upenn-embedded/final-project-s26-t16-1/README.md

Review Assignment Due Date (https://classroom.github.com/a/-Acvnhrq)

# Final Project

**Team Number:** T16

**Team Name:** Sewing Machine

| Team Member Name | Email Address |
| --- | --- |
| Chris Chen | chrisc05@seas.upenn.edu |
| Ivy Jiang | ivyjiang@seas.upenn.edu |
| Evelyn Li | eli22@seas.upenn.edu |
| Daniel Lin | dl1n@seas.upenn.edu |

**GitHub Repository URL:** https://github.com/upenn-embedded/final-project-s26-t16-1

**GitHub Pages Website URL:** https://upenn-embedded.github.io/final-project-s26-t16-1/

## Final Project Proposal

### 1. Abstract

Our final project is a smart sewing machine with a wireless foot pedal and built-in thread usage tracking. The wireless pedal will use a pressure sensor to detect how hard the user is pressing and send that input wirelessly to the sewing machine, which will adjust motor speed in real time. A second part of the system will track spool or shaft rotation to estimate how much thread remains and display that information to the user on an LCD screen or other indicator. Overall, the project combines wireless communication, sensor input, motor control, and user feedback into one integrated embedded system.

### 2. Motivation

Conventional sewing machines usually use wired pedals and provide limited real-time information about machine operation. This creates usability limitations, including restricted pedal placement and difficult portability. Furthermore, there is no clear indication of the remaining thread or machine state. This is especially annoying when sewing complex pieces; users have to guess and check when to replace bobbin and spool thread and precision is limited by eyeballing. Our project addresses this by adding a wireless pressure-sensitive pedal and a sensing system that estimates thread usage during operation.
This project is interesting because it requires real-time interaction between mechanical and embedded subsystems. The device must sense pedal pressure, filter and transmit the input, adjust motor speed, count machine rotations, and provide output through a display or indicators. The intended purpose is to build a more flexible and informative sewing machine system that improves user control while demonstrating strong embedded system integration. It is also just cool because some members in our group love to sew and the chain locking mechanism is a marvel in itself, so it could be a cool mechanism to figure out.

### 3. System Block Diagram

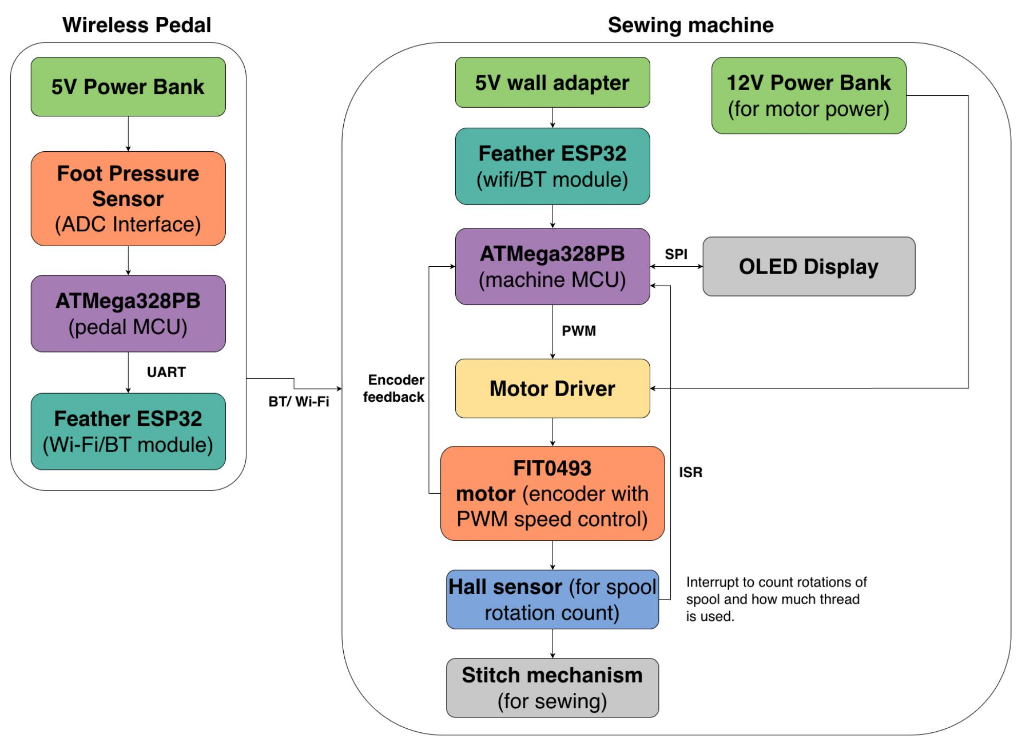
[picture p1: block_diagram.png]
 

### 4. Design Sketches

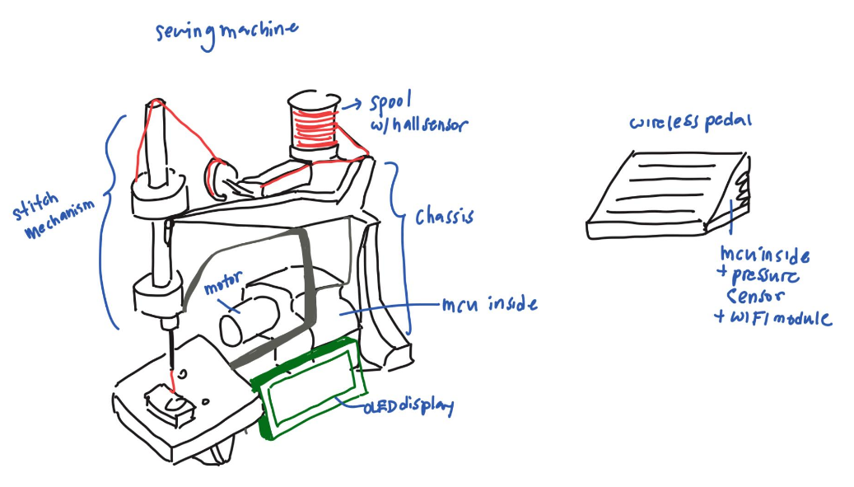
[picture p2: design_sketches.png]
 

We will need to 3D print the sewing machine components. Further, for the body and internal support of the machine, we will need power tools to cut it out of wood or acrylic.

### 5. Software Requirements Specification (SRS)

**Pedal Pressure to Speed Mapping**
The pedal MCU reads pressure and maps it to motor speed (higher pressure → higher speed).
Validation: Apply ≥5 pressure levels and verify speed increases monotonically.

**Wireless Command Transmission**
The pedal MCU sends speed commands wirelessly to the sewing machine MCU.
Validation: Perform ≥20 trials with ≥95% successful reception and response.

**Real-Time Motor Control**
The machine MCU adjusts motor speed based on pedal input.
Validation: Test ≥5 inputs and verify speed settles within 2 s.

**Rotation Counting**
The MCU tracks rotations using an encoder, Hall, or optical sensor.
Validation: Compare measured vs. actual rotations with ≤5% error.

**Thread Estimation**
Remaining thread is estimated from rotation count and spool geometry.
Validation: Compare estimate vs. expected value with ≤10% error.

**User Feedback**
System provides status via LED/OLED (power, thread, state).
Validation: Verify LED power indication and display updates during operation.

**Chain Stitch Mechanism**
The mechanism produces a continuous chain stitch.
Validation: Test on fabric and verify stitch remains continuous.

**Power Transmission**
Motor drives stitching mechanism without slip or stall.
Validation: Test across speed range and verify consistent motion.

**Frame Stability**
Structure remains stable during operation.
Validation: Run for several minutes and check for vibration or loosening.

**Pedal Usability**
Pedal supports repeated presses and returns to neutral.
Validation: Perform ≥50 cycles and verify consistent return and integrity.

**Spool Support**
Spool rotates smoothly and remains mounted.
Validation: Run repeated tests and verify no jamming or detachment.                                                                     |

### 6. Hardware Requirements Specification (HRS)

**Wireless Foot Pedal Hardware**
The system includes a portable foot pedal with an embedded pressure sensor and microcontroller to detect user input and transmit speed commands wirelessly.
Validation: Apply repeated low, medium, and high pressure inputs and verify that the pedal produces distinct sensor readings and successfully transmits commands.

**Dual-MCU Architecture**
The system uses two separate microcontrollers: one in the wireless pedal for pressure sensing and transmission, and one on the sewing machine for motor control, display output, and spool/thread monitoring.
Validation: Test each MCU separately, then validate the full system by confirming that pedal input is received and acted on by the machine-side MCU.

**Motor Drive Hardware**
The sewing machine includes a motor and motor driver capable of rotating the stitching mechanism at variable speeds based on pedal input.
Validation: Operate the motor at multiple commanded speeds and verify continuous rotation and response to speed changes without stalling under normal operation.

**Rotation Sensing Hardware**
The machine includes a sensor, such as an encoder, Hall-effect sensor, or optical sensor, to detect spool or shaft rotation for thread-usage estimation.
Validation: Rotate the shaft or spool through a known number of turns and verify that the sensor output matches the actual number of rotations.

**User Feedback Hardware**
The system includes at least one output device to indicate machine status, such as an OLED display or LED indicators.
Validation: Power on the system and confirm that the display or indicators activate correctly and update during operation.

**Power System**
The device includes a power source and regulation hardware capable of safely powering both microcontrollers, the wireless pedal, sensors, display, and motor-driving circuitry.
Validation: Run the full system under normal operation and verify that all components remain powered and functional without unintended resets or brownouts.

**Pressure Sensor Resolution**
The foot pedal pressure sensor provides enough range to distinguish at least three input levels: low, medium, and high pressure.
Validation: Record sensor outputs at different applied pressures and confirm that the three levels are clearly distinguishable.

### 7. Bill of Materials (BOM)

[BOM](https://docs.google.com/spreadsheets/u/1/d/1LjAFRgd7g9gQXnkkUFB2_QBa0-whRiNNrxztL-SXp3Q/edit?usp=sharing)

First, the source of our compute/signal processing for this project is the ATmega328PB XPlained mini board. This is ideal because it provides sufficient compute for processing of simple sensor data, is cheap and highly flexible when tuned with baremetal code. To facilitate wireless communication between two of these boards, a Feather ESP32 Wi-Fi module will be connected to each MCU. This is preferred because the Feathers provide bluetooth capabilities that are ideal for short distance, light-weight communication. They also provide access to wifi which gives us the flexibility of incorporating data storage, and IOT with this system without requiring significant changes in storage.
For our power source, we will utilize 3 sources in our testing phase. A 5V power bank will be utilized to power our foot pedal. A power bank is preferred because they have built in power regulation and are small and portable which is the entire purpose of having a detached foot pedal. 5V adapters plugged into the walls will be used to power the peripherals on the sewing machine side. For the motor, a separate 12V supporting 2A power adapter plugged into the wall will be used. We want to separate the power supply of the motor from the peripherals because the motor can cause significant current/voltage spikes.
Our pedal must be able to distinguish between multiple states which we do using a pressure sensor. We chose the FSR 402 because it has a sensing range of 0.3N to 150N which is the relative range that makes the pedal easy to control and not require too much force. The sensor is also durable supporting 10 million + actuations and has mm thickness.
For our motor, we choose the FIT0493 motor because it is relatively inexpensive, contains a built in encoder, supports PWM and should have more than enough torque at 12kg/cm. It takes 12V and draws a max current of 1.65A. Our motor driver supports this by being able to provide up to 3A. This is all supported by our 12V adapter.
We also require an LCU to display information to the user. In all honesty, the specs for this are unimportant for the operation of the device as long as SPI communication is supported.
We also use a hall-effect latch for spool rotation tracking rather than an optical sensor because sewing might produce significant debris and a magnetic sensor handles that well. Our chosen sensor takes in 5V and only requires 5mA to operate which matches well within the rest of the system.

### 8. Final Demo Goals

Will it be strapped to a person, mounted on a bicycle, or require outdoor space?

* It is a standalone machine with a portable foot pedal and connected to a battery, so no need to be strapped to anything or anyone.

Think of any physical, temporal, and other constraints that could affect your planning.

* Some constraints that can affect planning is that a sewing machine isn’t something that we can fit in a bag; it is quite big, so storage could be a constraint as well as methods to transport the parts back and forth.

### 9. Sprint Planning

How will you plan your sprint milestones?

* We will plan our sprint milestones as semi-long term goals. Focus on 1-2 big goals max and separate into 2 person groups to complete mini parts that work up to completing the overarching goal. For example if the unit time is 1 week, we will have the goal we want completed by the end of the week defined clearly. After defining this goal, define the sub goals that will be completed to complete the overall goal. Then, block out specific time blocks throughout the week to fulfill each goal. Finally, leave a few hours in case some tasks take longer than anticipated.

How will you distribute the work within your team?

* Everyone will be present when planning the sprints. We will just discuss which work we want to do and split accordingly. Nothing will be assigned without approval and we will discuss during in person sprint planning and over text for unanticipated tasks that come up.

**This is the end of the Project Proposal section. The remaining sections will be filled out based on the milestone schedule.**

## Sprint Review #1

### Last week's progress

This past week, we finalized BOMs (and ordered), worked on an intial physical CAD (and sent out to print) and wrote an inital version of the embedded code for the foot pedal system.

In terms of the BOM, the biggest change we made compared to the inital write up was we switchd the force sensor to a different model with a larger surface area for ease of integration and use. We also realized the power adapter we were planning on using does not source enough current to account for spikes in the motor so we made changes to this.

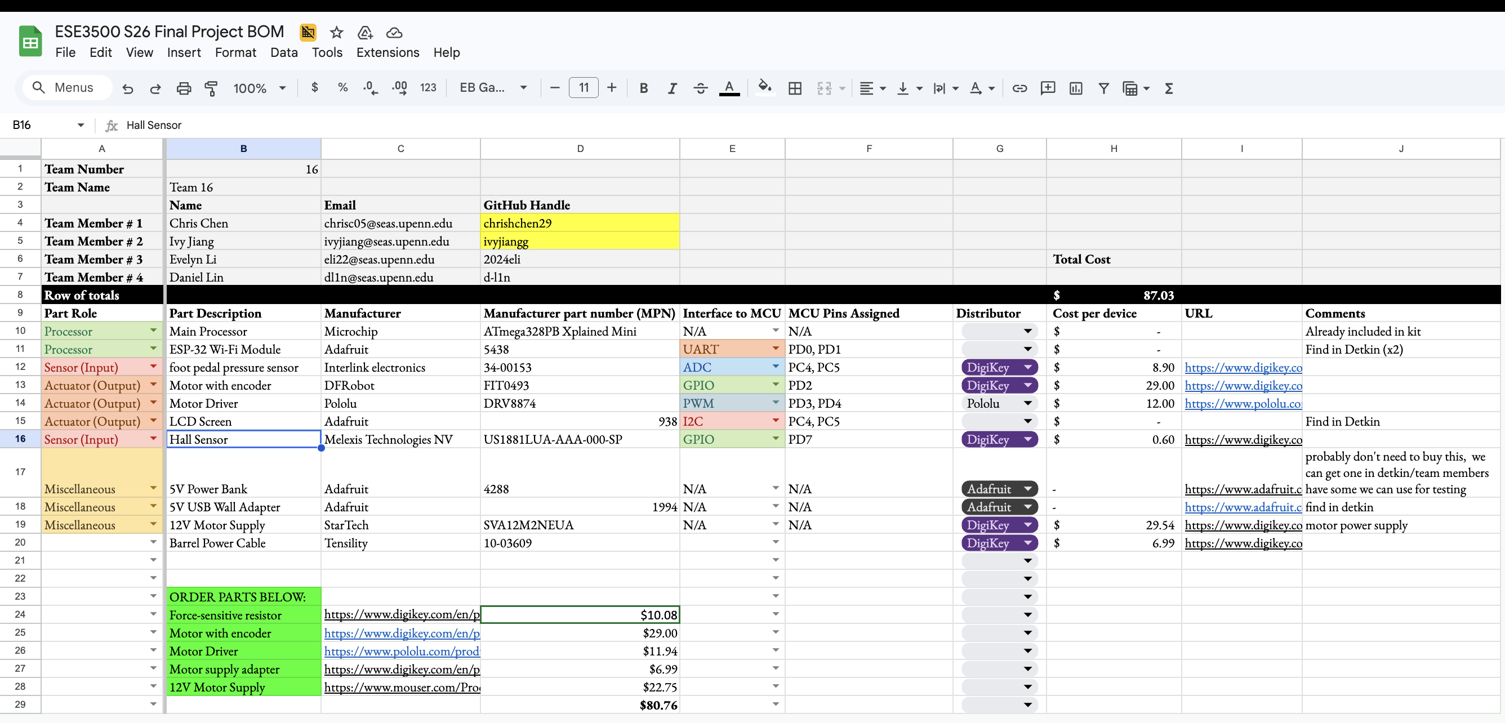
[picture p3: bom_wk1.png]


In terms code for the foot pedal, we have written and tested the functionality for measuring and reading the force from the sensor. This is the core of the control system.

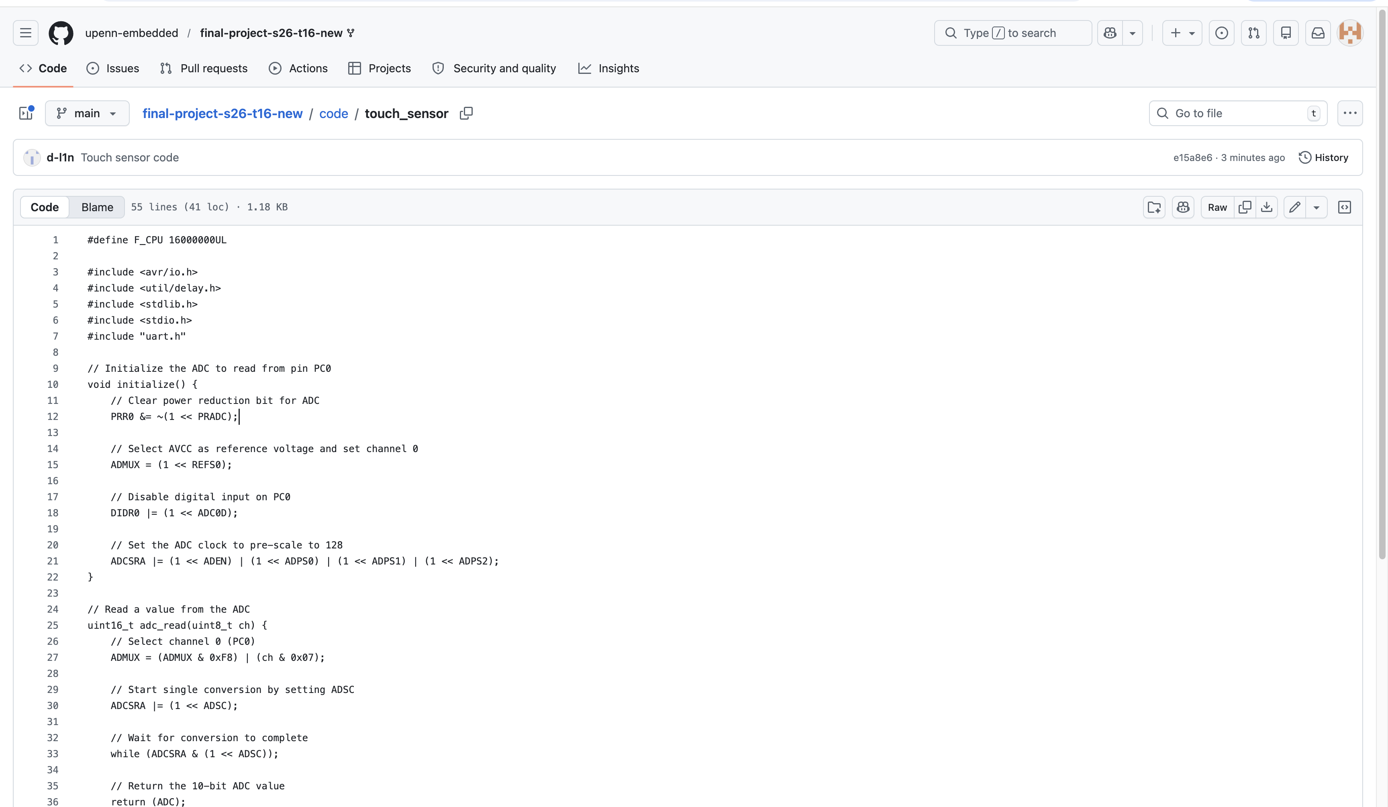
[picture p4: code-wk1.png]


For the physical CAD, we started from example CAD models on the internet and made the necessary adjustments to incorporate our components and detach the foot pedal from the rest of the machine to make our design more convenient and portable. Some of our components that we sent for printing are shone below.

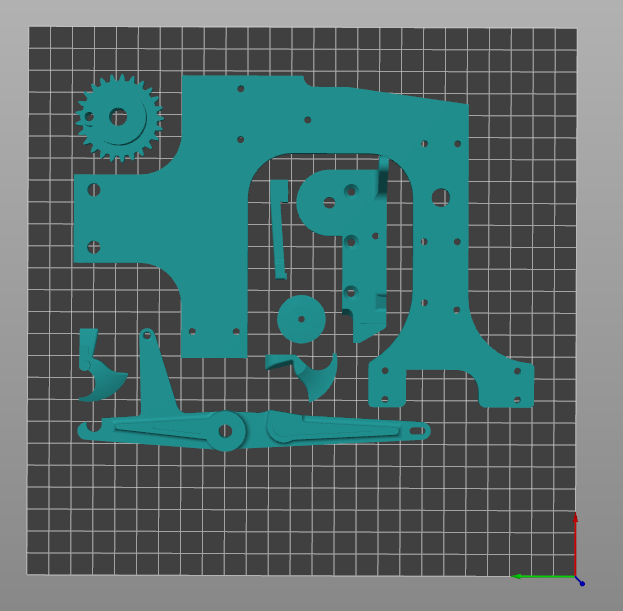
[picture p5: cad_photo_wk1.png]


Finally, we met as a team and aligned on direction and plans/goals for next week.

### Current state of project

Currently, the project is off to a good start. We have a very basic preliminary MVP of our "foot-pedal" system (both circuit and code) which is a core part of the project that will ultimately allow the user to control the sewing machine. We also have a first version for the gears and enclosure of the sewing machine.

Right now, the biggest bottleneck is just waiting for components to come in. That is, we have ordered electronic parts and are awaiting those to ship. We have also sent out 3D print jobs to RPL and are waiting for the first print to come back so we can iterate. The reason we want to the physical enclosure to come right now 1. printing takes a long time and 2. we want to make sure the elecontric components fit within the mechanical CAD and the gear works as expected.

In the meantime we are able to progress with components that are in Detkin. Some of these are parts we will use in our final version (feather, LCD screen, Hall sensor etc.) and some are alternate versions we are just using for test (force sensor, small motor)

### Next week's plan

Estimated time: 2 hours
Assigned: Daniel, Chris

Finalize foot-pedal subsystem - stress test code, integrate feather for wifi communication, integrate LCD screen displaying status. Being done means have a working system that consistently measures accurate pressue, is able to send it wirelessly and display it visually. Provided 3D print finishes in time, we also want to have this integrated. This group will also be responsible for following up with the 3D print and ensuring all components are printed/accounted for.

Estimated time: 2 hours
Assigned: Evelyn, Ivy

Begin the code and electronics to measure the amount of yarn left/used. This will mean building and testing the hall sensor electroncs and writing the code to support this. We also want to integrate feather for wifi communication on the ATMega connected to this system. Being done means having a hall sensor that can accurate measure rotations and communicte that via wifi.

*Note: not too much work assigned for this sprint due to midterms and team plans to meet for long work session the Sunday immediately after Sprint 2 is due.

## Sprint Review #2

### Last week's progress

This past week, we wrote code to verify the functionality of the hall-effect sensor set up the circuitry. The hall effect is up and functional.

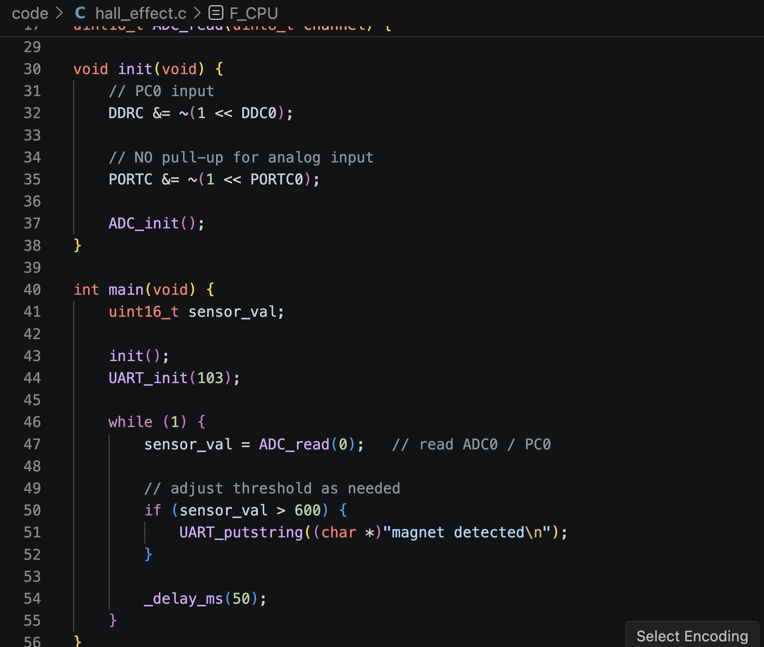
[picture p6: sprint2-hall.png]


We also partially assembled our mechanical sewing machine.


We re-CAD'd/ordered additional parts based on first iteration assemblies. We realized we need metal rods to support the physicaly sewing machine and act as axels for spinning parts. The power supply we ordered was also missing part of the adpater so we reordered this too.

We also cadded the enclosure for the foot pedal sensor and MCU.
text

Our motor driver came so we created a basic test circuit and verified that it works by driving a PWM signal using the detkin power supplies.
text

### Current state of project

I think currently we are on good pace. The hall effect sensor, motor, force sensor all have rough, working versions set up. The next step will be to polish up code a bit more and connect all these sections together via the ESP-32. We wanted to get this done last week, but we realized this is lower priority because other tasks require more iteration and may require ordering of additional parts + 3D printing new components which has a longer lead time.

The biggest current roadblocks are 1. we are waiting for metal rods to come in so that we can finish the mechanial assembly of our sewing machine. We are also waiting for the new power adpater head to come in so that we can test the operation of our project without relying on the power supply.

In the meantime, we will keep testing and integrating using the detkin power supply. We have also 3D printed rods that we can use for now while we wait for the metal rods to come in.

### Next week's plan

Assigned: Evelyn, Ivy, Daniel, Chris
Estimated time: 8 hours

We will fully assemble the sewing machine and test to see if the motor can move the machine. We will also attach the hall sensor and magnet to the spool in order to measure rotations. We will also connect the LCD screen so that it displays rotations.

Overall, we want to polish the different electrical subsystems and integrate them together and support wireless communication. We hope to be ready for the MVP!

## MVP Demo

### 1. Show a system block diagram & explain the hardware implementation.

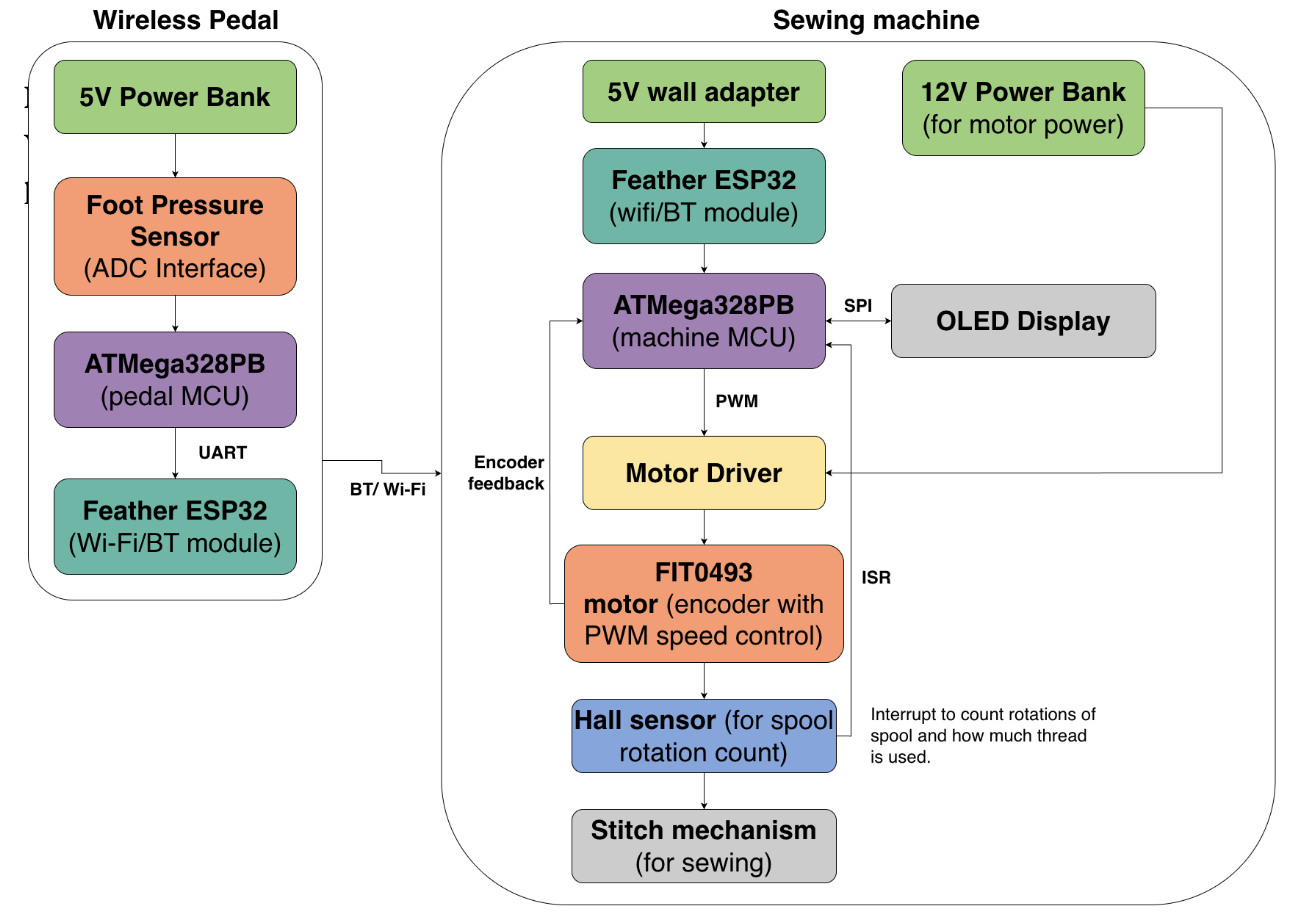
[picture p8: mvpblock.png]
mvpblock


In our current version of the MVP, we have an ATMega328PB (the peripheral controller) that takes in as ADC input the value from a force pressure sensor. This is transmitted via UART to an ESP32 Feather, which transmits the ADC value wirelessly to a second ESP32. The second ESP32 transmits this ADC value via UART to a second ATmega328PB (the central controller), which interprets the value and changes the duty cycle of the PWM signal that enables the DC motor accordingly. We power the peripheral ATmega328PB and the ESP32 using 6 AA batteries in series (9V nominal), with an LDO down to 5V.

### 2. Explain your firmware implementation, including application logic and critical drivers you’ve written.

For firmware, we implemented the embedded control stack across two microcontrollers that coordinate the sewing machine. On the pedal-side controller, Daniel wrote ADC sensing logic to continuously sample the pressure sensor, filter readings, and convert force input into a speed command. We then built the wireless communication layer using ESP-NOW/Wi-Fi to transmit pedal data with low latency and confirm successful packet delivery.

On the sewing-machine controller, we developed/used existing UART drivers and wrote parsing logic to receive commands from the wireless bridge, then used that data for real-time motor control so pedal pressure directly maps to motor speed. Also wrote application logic for telemetry peripherals, including Hall-effect sensor (showing that we can sense change but haven't fully done rotation counting yet) for thread usage estimation and display update routines for user feedback, but these haven't been fully integrated as they were secondary priorities.

### 3. Demo your device.

Showing a TA + will record.

[20260417_113638_IMG_5753.MOV](assets/20260417_113638_IMG_5753.MOV)

### 4. Have you achieved some or all of your Software Requirements Specification (SRS)?

We achieved almost all of our SRS indepenently and still need to integrate them. The wireless transmission of the foot pedal force to the motor speed works well, and we validated the Hall effect sensor reading separate from this. We still have to setup the LCD screen to print the spool remaining and other parameters.

### 5. Have you achieved some or all of your Hardware Requirements Specification (HRS)?

We've fully built out our sewing machine and all parts are electrically integrated into separate parts of the system and controllers, but we haven't put any of the electronics onto the machine. The integration testing will consist of using the DC motor to actually spin the mechanical enclosure, which are sparate parts at the moment.

machine_assembly


mvpelectronics


### 6. Show off the remaining elements that will make your project whole: mechanical casework, supporting graphical user interface (GUI), web portal, etc.

We need to put the electronics on the sewing machine and figure out how to wire everything efficiently. As for main peripherals left, we mostly just telemetry which means setting up an LCD display (similar to Lab 4 Pong) and feeding spool count data into it.

### 7. What is the riskiest part remaining of your project?

Stress testing and making sure we don't break the machine as well as making sure all parts stay in tact when rewiring and integrating into the machine. We used 3D-printed rods instead of metal rods for the rotating pieces of the mechanical assembly, which can be risky as 3D-printed parts are much more brittle and prone to tolerance issues. This means we would likely not be able to sew any thick fabrics.

### 8. What questions or help do you need from the teaching team?

None as of now. Just maybe how to improve?

### Current state of project

We are in good shape for the final demo. Almost everything works functionally except for the display and hall effect sensor for telemetry which is a stretch goal that we can work on in the following week.

### Next week's plan

We will integrate the display and hall effect sensor for telemetry into the sewing machine and integrate it into existing code. Since we've finished a rough MVP for this week, we can now work on polishing the circuit boards -- soldering rather than using breadboards and putting it on the machine -- as well as making our code readable and modularized. Also we would like to stress test our machine to make sure it won't break on Demo Day.

## Final Report

Don't forget to make the GitHub pages public website!
https://upenn-embedded.github.io/final-project-s26-t16-1/

***NOTE!!! Our final website is made using our index.md file NOT this README
# Gertrude

ESE3500 Final Project: Embedded Sewing Machine for wireless control and smart resource usage prediction

</div>

<div class="section" markdown="1">

## Video

<div style="position: relative; padding-bottom: 56.25%; height: 0;">
  <iframe 
    src="https://www.youtube.com/embed/aF5EwkLu-dE" 
    frameborder="0" 
    allowfullscreen
    style="position: absolute; top: 0; left: 0; width: 100%; height: 100%;">
  </iframe>
</div>

[Open demo video](https://www.youtube.com/watch?v=aF5EwkLu-dE)

</div>

<div class="section" markdown="1">

## Images

<div class="image-grid">
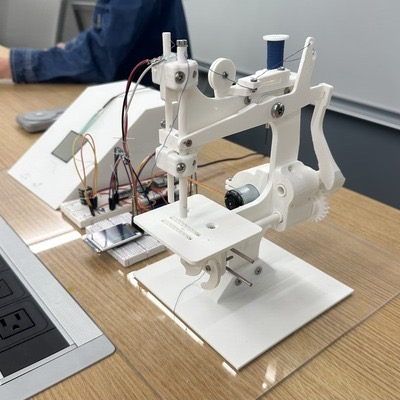
[picture p11: final images/400x400.JPG]
400x400 Thumbnail
  
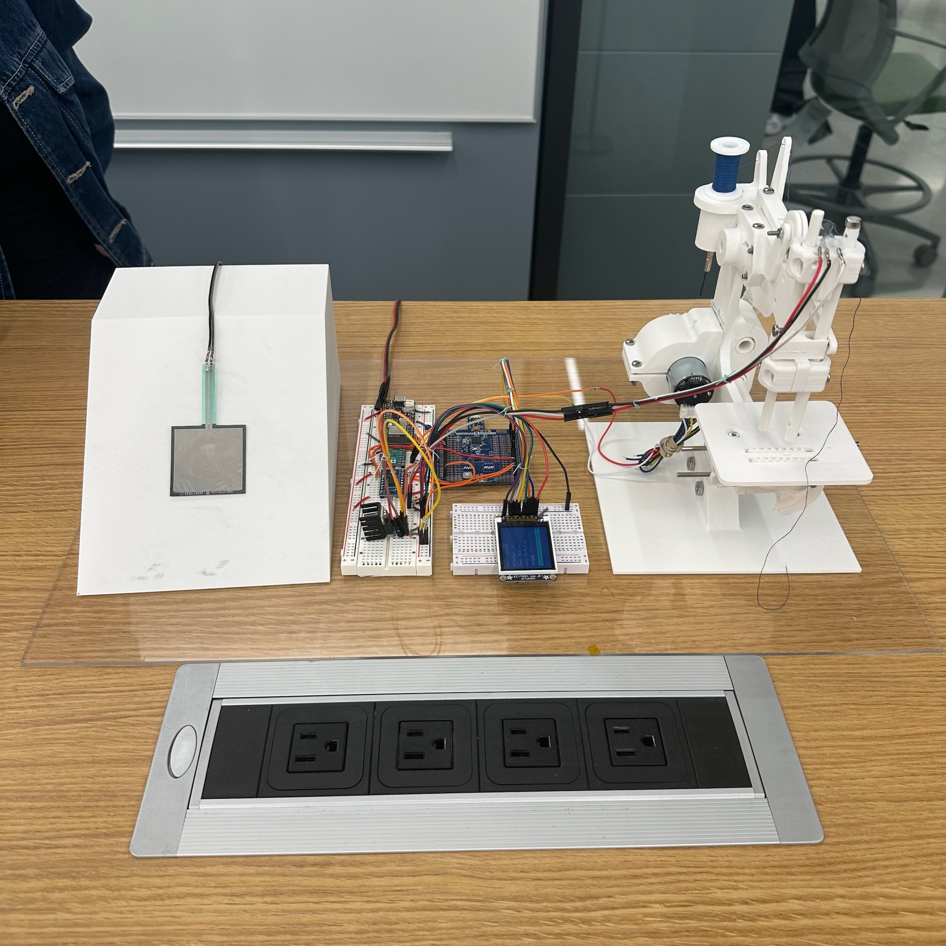
[picture p12: final images/IMG_1396.jpeg]
Final project image
  
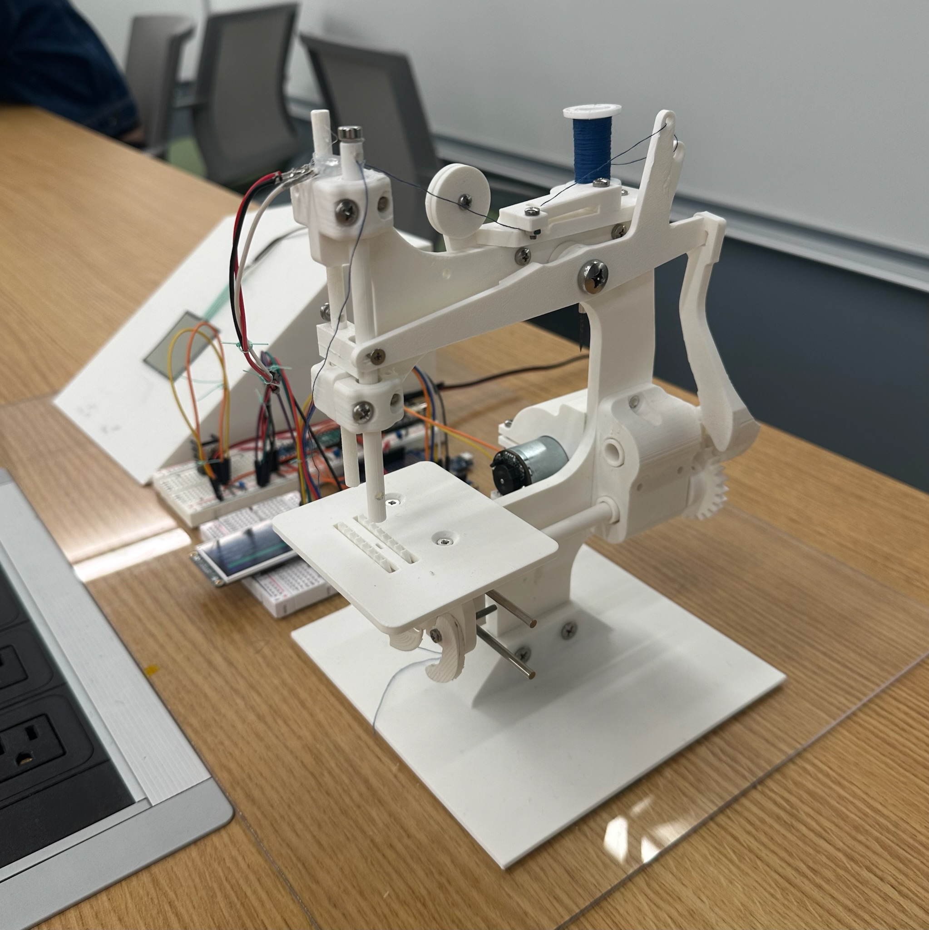
[picture p13: final images/IMG_1398.jpeg]
Final project image
  
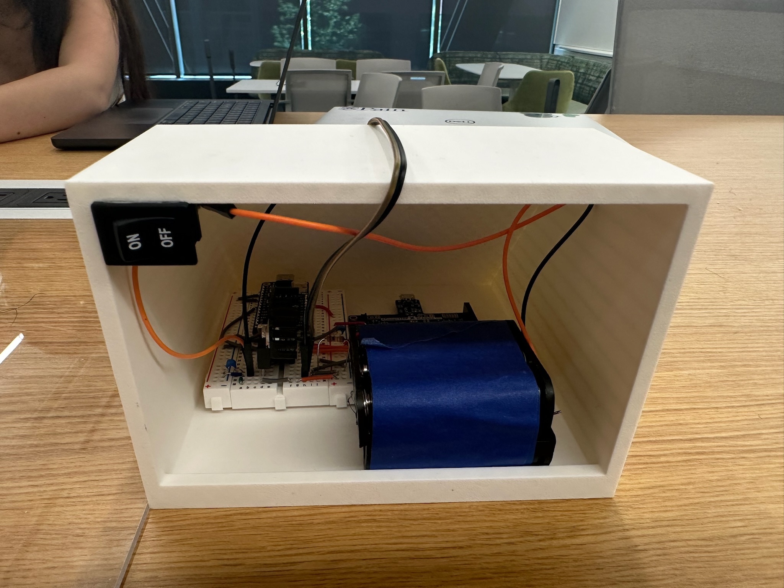
[picture p14: final images/IMG_1401.jpeg]
Final project image
  
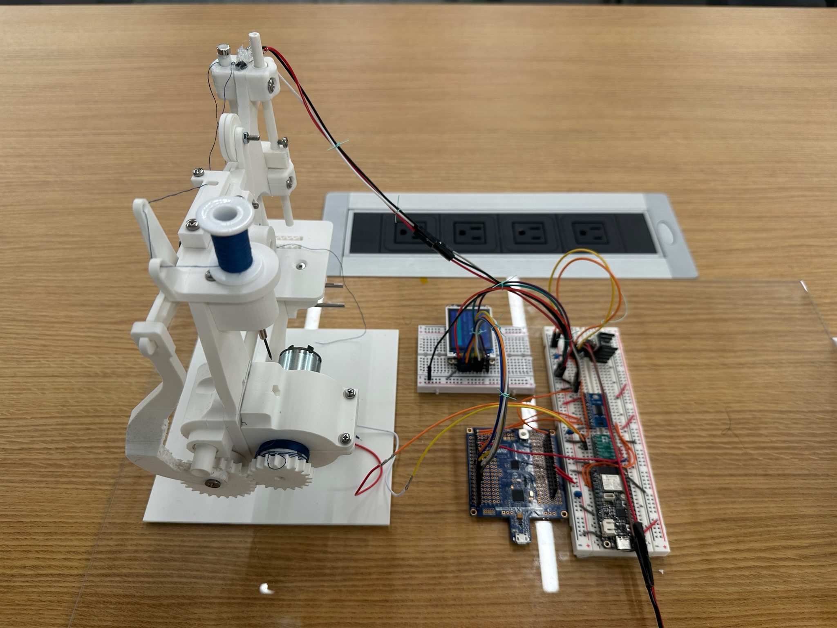
[picture p15: final images/IMG_1403.jpeg]
Final project image
  
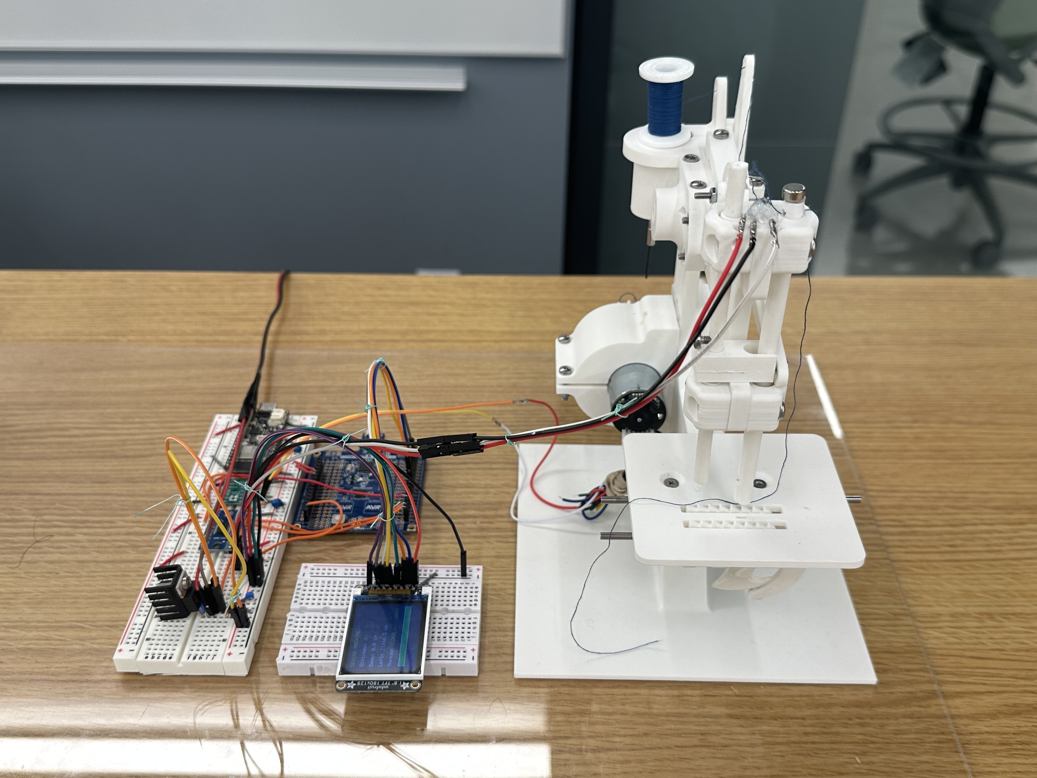
[picture p16: final images/IMG_1404.jpeg]
  
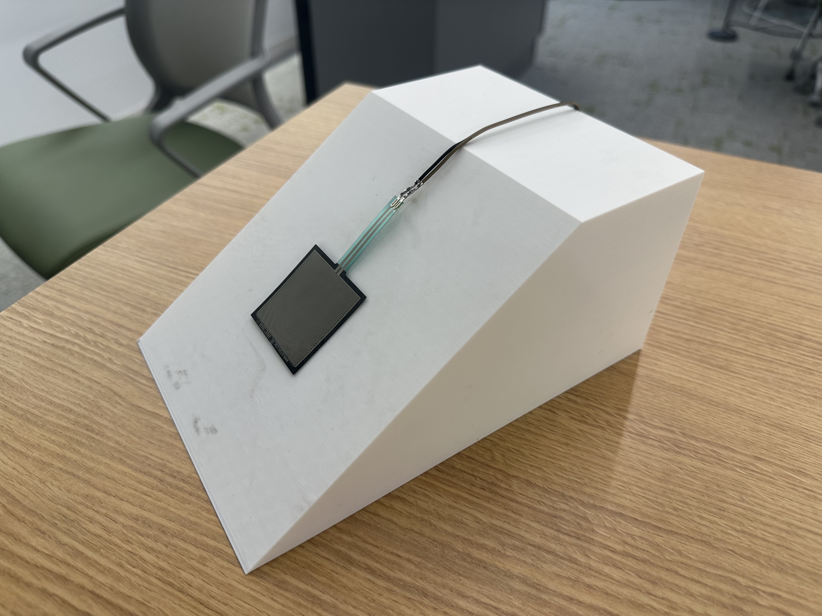
[picture p17: final images/IMG_1406.jpeg]
  
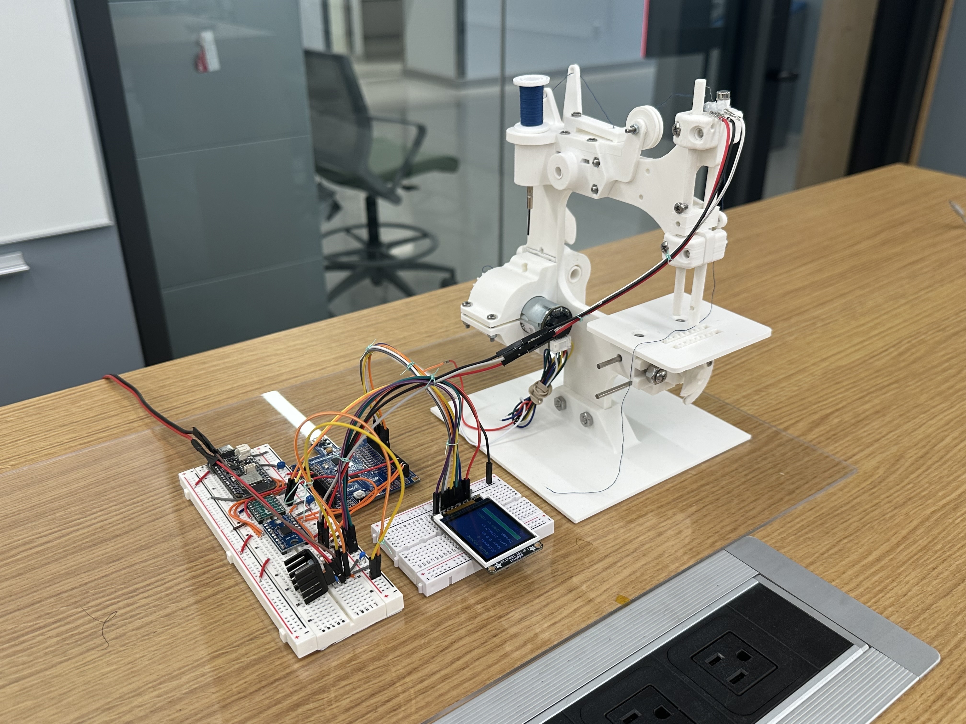
[picture p18: final images/IMG_1407.jpeg]
  
</div>

</div>

<div class="section" markdown="1">

## Progress Shots

<div class="image-grid">
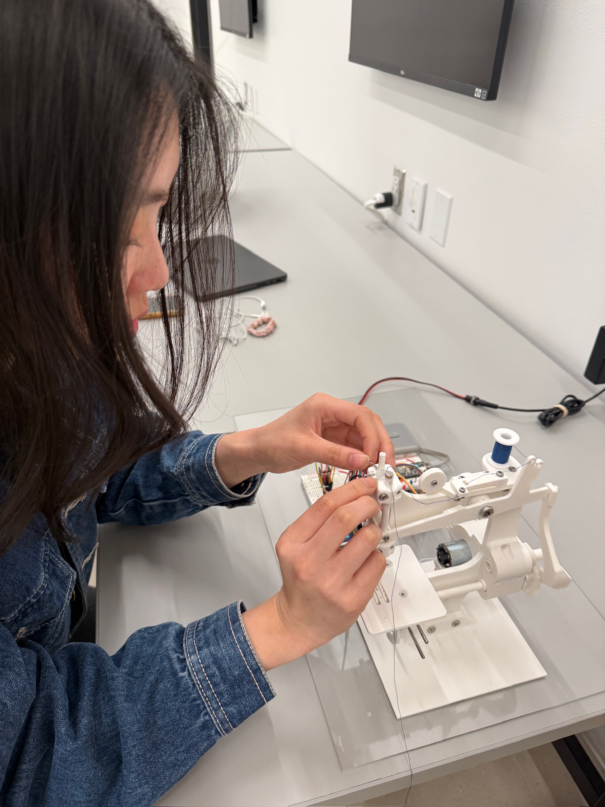
[picture p19: progress/IMG_4221.JPG]
Progress shot
  
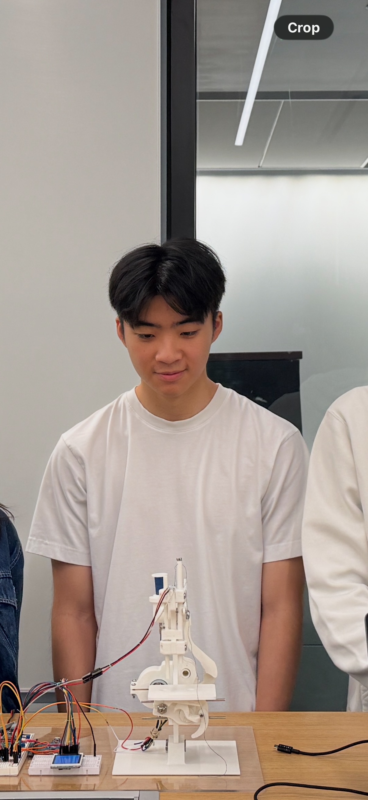
[picture p20: progress/IMG_4233.jpeg]
Progress shot
  
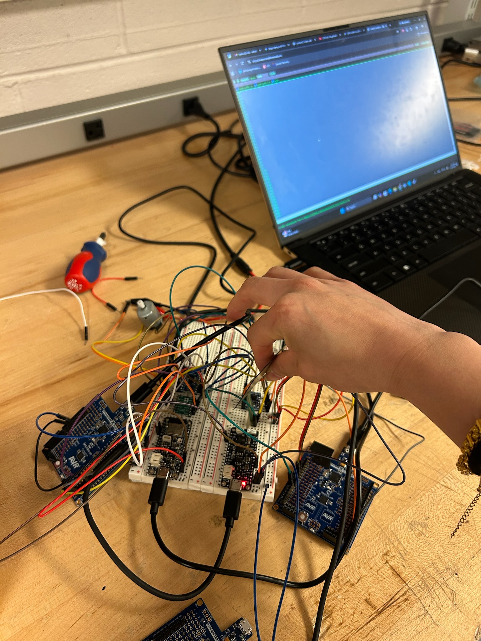
[picture p21: progress/IMG_5754.jpeg]
Progress shot
  
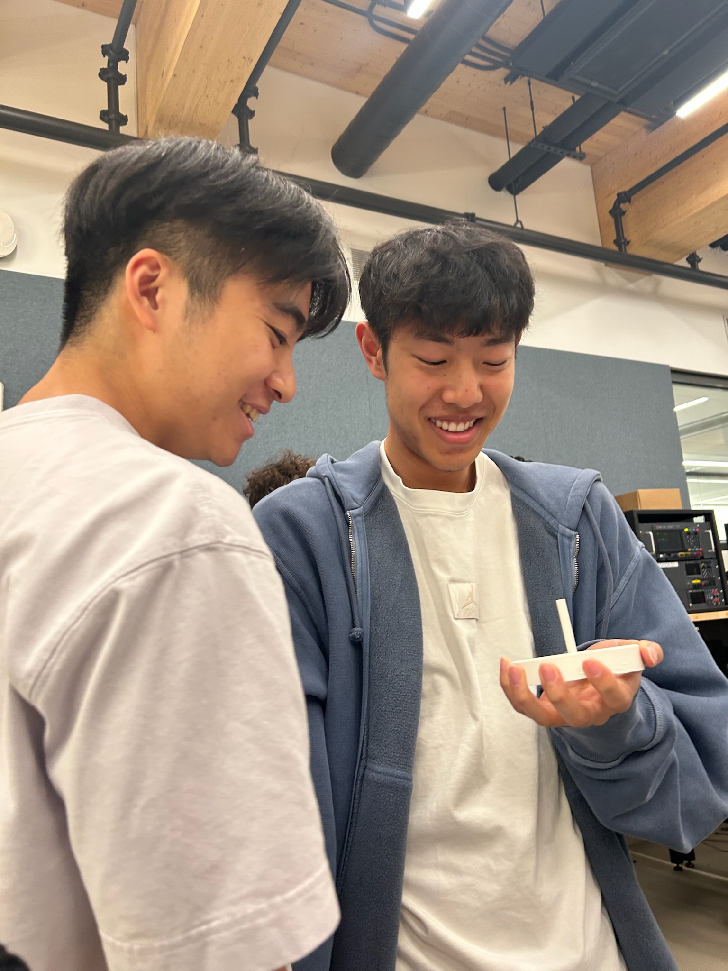
[picture p22: progress/IMG_6074.jpeg]
Progress shot
  
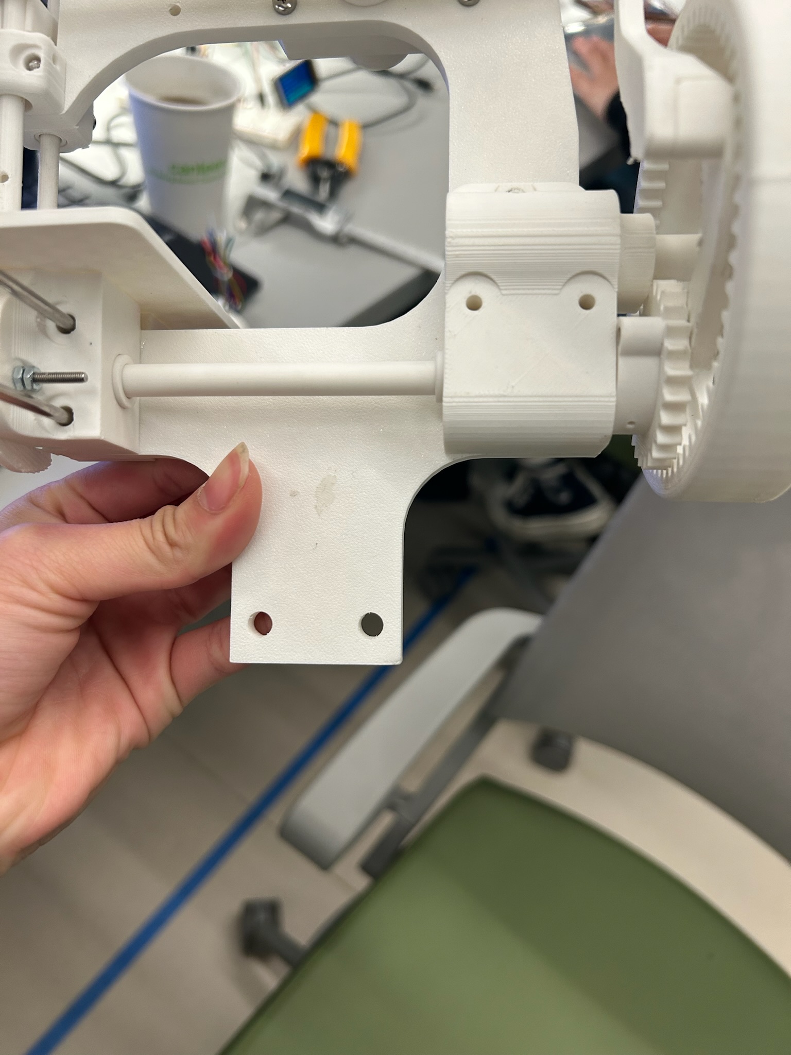
[picture p23: progress/IMG_5991.jpeg]
Progress shot
  
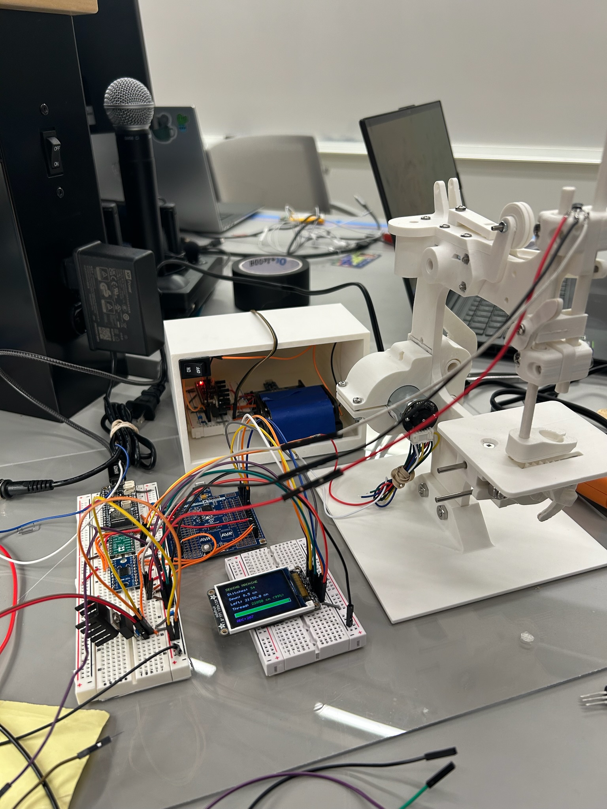
[picture p24: progress/IMG_6068.jpeg]
Progress shot
  
  MVP block diagram
  Progress shot
</div>

</div>

<div class="section" markdown="1">

## Results

In the end, our sewing machine "Gertrude" was very close to the product we envisioned
from the beginning. It contained a PLA 3-D printed sewing machine complete with fully
function gears, hooks and pedals powered by a DC motor. It possessed a detached
"foot-pedal" that utilized a force sensor to control the speed of the sewing machine and
use 2 ATMegas to handle embedded computations and 2 ESPs running ESP-Now to handle
wireless communication. Finally, a hall effect sensor was used to measure yarn usage
and display relevant information like "total stiches" on an onbard LCD screen.

</div>

<div class="section" markdown="1">

## Software Requirements Specification (SRS) Results

Based on our quantified system performance, we were able to meet most of our core software requirements, particularly those related to user interaction and system feedback. The LCD display requirement (SRS-06) was fully achieved, as the system consistently provided real-time updates of stitch count and system status. This demonstrated strong integration between sensing, processing, and user output, and validated that our software pipeline from sensor input to display was reliable.

However, we fell slightly short in fully meeting the rotation counting requirement (SRS-04). While the Hall-effect sensor successfully detected and tracked spool rotations, small inaccuracies were observed, especially at higher motor speeds. These errors were likely caused by missed sensor transitions or noise in the signal, indicating limitations in our polling or interrupt handling approach. Although the system functioned correctly at a conceptual level, the measured counts did not always remain within the desired accuracy range.

Overall, the system achieved its primary functional goals, with reliable real-time control and feedback. The remaining shortcomings are primarily related to signal robustness and measurement precision, which could be improved through better interrupt handling, signal conditioning, or filtering in future iterations.

| ID | Description | Validation Outcome |
| --- | --- | --- |
| **SRS-04** | The sewing machine microcontroller shall track spool or shaft rotations using a Hall-effect sensor. | Partially Confirmed, the Hall sensor and magnet successfully incremented rotation/stitch count displayed on the LCD, matching visible spool movement during operation. Minor inaccuracies occurred at higher speeds due to missed transitions or signal noise. Demonstrated in demo video and system output 
| **SRS-06** | The system shall provide user feedback through an LCD display to indicate system status and usage metrics such as stitch count. | Confirmed, the LCD powered on correctly and updated in real time to reflect stitch count and system state during operation. Consistent behavior is shown in demo video and images 

SRS-04 Proof:

<div style="display: flex; justify-content: center;">
  <iframe 
    width="315" 
    height="560"
    src="https://www.youtube.com/embed/GNKjsASPulc"
    frameborder="0"
    allowfullscreen>
  </iframe>
</div>

[Open SRS-04 proof video](https://www.youtube.com/watch?v=GNKjsASPulc)

SRS-06 Proof:

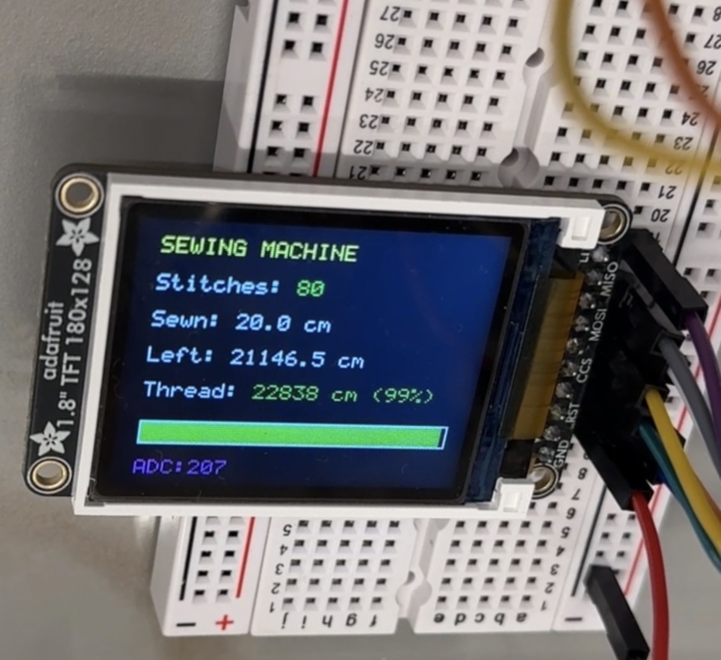
[picture p25: lcdscreensrs.jpg]
SRS-06 Proof


</div>

<div class="section" markdown="1">

## Hardware Requirements Specification (HRS) Results

We met almost all of the hardware requirement initially outline in our project proposal. A brief overview of these requirments and our ultimate design is discussed below:

### Wireless Foot Pedal Hardware

The system shall use two separate microcontrollers: one located in the wireless pedal for pressure sensing and transmission, and one located on the sewing machine for motor control, display output, and spool/thread monitoring.

Validation: Yes, this was met and the locations were as planned. This is demonstrated in the images above.

The sewing machine shall include a motor and motor-driving circuit capable of rotating the stitching mechanism at variable speeds based on pedal input.

Validation: Yes, this was met, and a functioning motor is outline in the demo video.

The machine shall include a hardware sensor, such as an encoder, Hall-effect sensor, or optical sensor, to detect spool or shaft rotation for thread-usage estimation.

Validation: We did include sensors to count spool usage/number of rotations in the form of a hall effect sensor and magnet. Agin, demonstrated in demo video.

The system shall include at least one hardware output device to indicate machine status, such as an OLED display and/or LED indicators.

Validation: The visual display came in the form of a status LED on the sewing machine side ATMega as well as the LCD screen turning on.

### Power System

The device shall include a power source and regulation hardware capable of safely powering both microcontrollers, the wireless pedal, sensors, display, and motor-driving circuitry.

Validation: This was achieved and functioning machine is proof of that. Specifcally, we utlized 6 AA batteries in series for a nominal battery voltage of 9V, 9V to 5V and 3.3V LDO, wall to 12V socket and fixed 5V portable power supply.

| ID | Description | Validation Outcome |
| --- | --- | --- |
| HRS-01 | The system shall include a portable foot pedal with an embedded pressure sensor and microcontroller to detect user input and transmit speed commands wirelessly. | Confirmed, could communicate wirelessly up to 50+ meters away. [Video1](validation/Video1.mov) shows example of wireless communication working. |
| HRS-07 | The foot pedal pressure sensor shall provide enough measurable range to distinguish between at least three user input levels: low, medium, and high pressure. | Confirmed, could see very visible differences in motor speed depending on force applied. End of demo video on website shows difference speeds, LCD screen shown in [Video1](validation/Video1.mov) also zooms in on ADC reading of pressure sensor. |

</div>

## Conclusion

In conclusion, we had a lot of fun but also learning moments working on Gertrude. We learned a lot about debugging and working step by step up from a minimum viable product to a fully embedded sewing machine. 
What went well was that we planned out our time very well and were able to rapidly prototype if a design wasn't working or if a part was missing. For instance, we initially had significant issues getting our UART bridge to work between the ATMega used to sense the ADC value on the pressure sensor to the ESP-32, transmitting over ESP-NOW to the second ESP-32, and getting the value from the secon ESP-32 to the second ATmega over UART for processing with the motor. We found this issue to be because we were trying to read from UART channel 2 on the second ESP-32 when in reality the ESP-32 we used only had two UART channels (channel 0 and channel 1). We spent significant time debugging this issue (on the order of several hours) and the fact that we planned our time very well meant that we were able to resolve issues like this without it pushing back our timeline too much. Another major issue we face was on the integration side. When we tried to integrate the code controlling our motor duty cycle with the code for the Hall effect sensor and the LCD screen, we found that neither the LCD screen nor the motor worked properly. We eventually found out that the cause of this issue was that both them motor driver and the LCD screen used timer 0 on different channels, so our integrated code only worked when we switched the LCD screen to timer 2.

We were also a super communicative team, so it was easy to know what to work on and how to get it done. Overall, pretty much everything worked except that the needle was misaligned causing our machine to be unable to stitch. To solve this problem, next time, we would probably align the hook better so that it could grab the needle thread at the right moment. In general, we could probably have spent more time iterating on the open-source CAD design we found to meet our design requirements, because some of the open-source CAD files did not match what we were looking for - for instance, the model we used was designed to be run with metal rods, but we only had access to 3D-printed rods which made the tolerance issues of our device worse. Overall, we're super proud of the team for pushing through challenges and making a functional sewing machine!

## References
ESP-Now 

UART Library (Labs 1-4)

LCD Library (Lab 4)
