upenn-embedded/final-project-s26-t16-1/index.md

<style>
  body {
    background: #fbf7ef;
    color: #263331;
  }

  .report {
    max-width: 980px;
    margin: 0 auto;
    padding-bottom: 36px;
  }

  .title-block {
    margin: 18px 0 28px;
    padding: 28px 0 18px;
    border-bottom: 3px solid #9fc9bd;
  }

  .title-block h1 {
    margin-bottom: 8px;
    color: #1f625f;
  }

  .title-block p {
    margin: 0;
    color: #536660;
    font-size: 1.1rem;
  }

  .section {
    margin: 26px 0;
    padding: 22px;
    background: #ffffff;
    border: 1px solid #d9ded3;
    border-radius: 6px;
  }

  .section h2 {
    margin-top: 0;
    color: #1f625f;
  }

  .section h3 {
    color: #33413e;
  }

  .image-grid {
    display: grid;
    grid-template-columns: repeat(auto-fit, minmax(190px, 1fr));
    gap: 12px;
  }

  .image-grid img {
    width: 100%;
    height: 190px;
    object-fit: cover;
    border: 1px solid #d9ded3;
    border-radius: 4px;
    background: #f2eee4;
  }

  table {
    display: table;
    width: 100%;
    border-collapse: collapse;
    background: #ffffff;
  }

  th {
    background: #e3eee4;
  }

  th,
  td {
    padding: 10px;
    border: 1px solid #d9ded3;
    vertical-align: top;
  }
</style>

<div class="report" markdown="1">

<div class="title-block" markdown="1">

# Gertrude

ESE3500 Final Project: Embedded Sewing Machine for wireless control and smart resource usage prediction

</div>

<div class="section" markdown="1">

## Video

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

[Open demo video](https://www.youtube.com/watch?v=aF5EwkLu-dE)

</div>

<div class="section" markdown="1">

## Images

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

</div>

<div class="section" markdown="1">

## Progress Shots

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

</div>

<div class="section" markdown="1">

## Results

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

</div>

<div class="section" markdown="1">

## Software Requirements Specification (SRS) Results

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

SRS-04 Proof:

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

[Open SRS-04 proof video](https://www.youtube.com/watch?v=GNKjsASPulc)

SRS-06 Proof:

SRS-06 Proof

</div>

<div class="section" markdown="1">

## Hardware Requirements Specification (HRS) Results

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

### Wireless Foot Pedal Hardware

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

Validation: Yes, this was met, and a functioning motor is outline in the demo video.

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

### Power System

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

Validation: This was achieved and functioning machine is proof of that. Specifcally, we utlized 6 AA battery back, 9V to 5V and 3.3V LDO, wall to 12V socket and fixed 5V portable power supply.

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

</div>

<div class="section" markdown="1">

## Conclusion

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

## References
ESP-Now 

UART Library (Labs 1-4)

LCD Library (Lab 4)

</div>
</div>
