upenn-embedded/final-project-s26-t16-1/final images/IMG_1402.jpeg

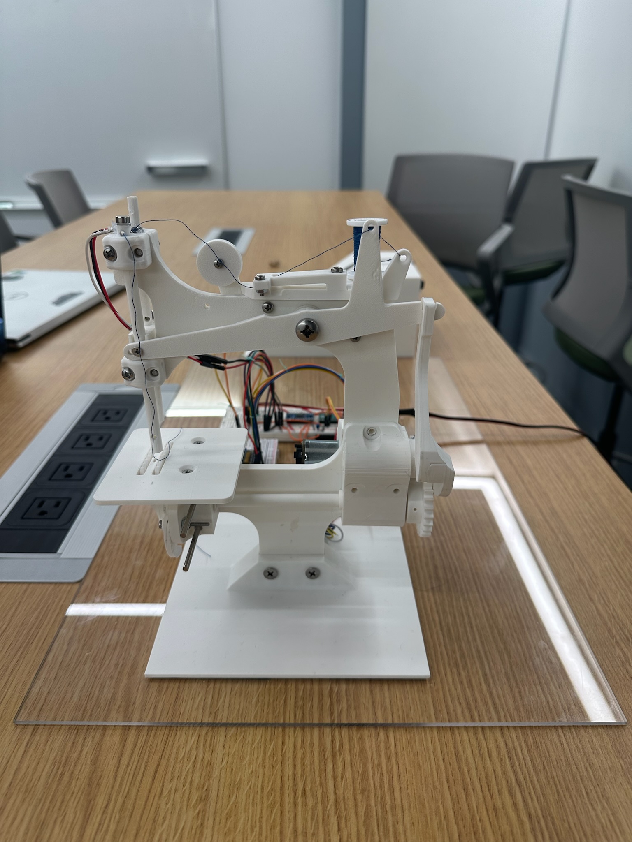
final images/IMG_1402.jpeg
