upenn-embedded/final-project-s26-t16-1/final images/thumbnail.JPG

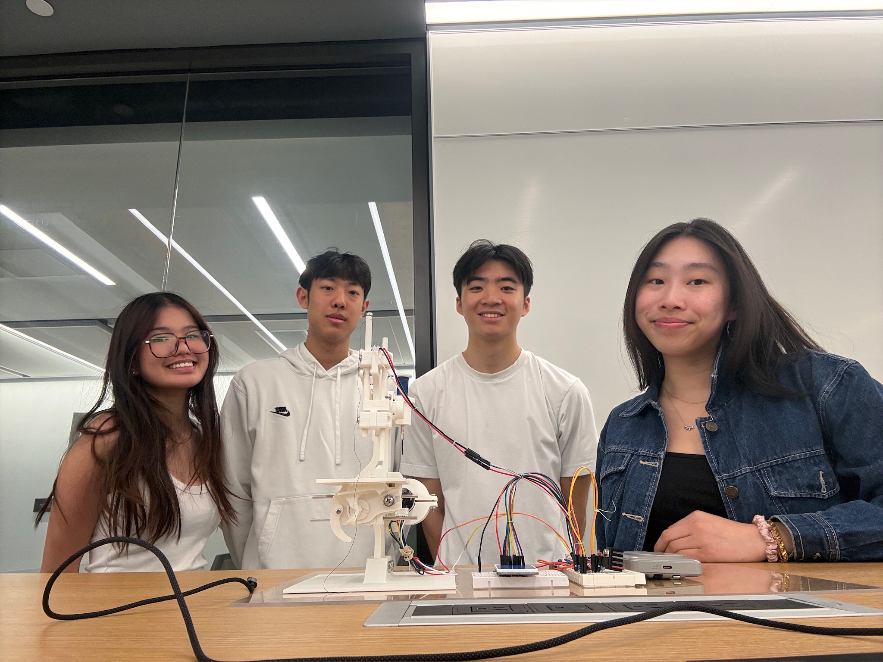
final images/thumbnail.JPG
