upenn-embedded/final-project-s26-t16-1/code/4-10/central_controller/central_controller.ino

#include <HardwareSerial.h>

HardwareSerial ATmegaSerial(2);
#define ATMEGA_RX_PIN 38 // ESP32 RX to ATmega TX (PD1)
#define ATMEGA_TX_PIN 33 // ESP32 TX to ATmega RX (PD0)

void setup() {
    Serial.begin(115200);
    ATmegaSerial.begin(9600, SERIAL_8N1, ATMEGA_RX_PIN, ATMEGA_TX_PIN);
    
    Serial.println("ESP32 Test Sender Ready.");
    Serial.println("Waiting 3 seconds before starting...");
    delay(3000);
}

void loop() {
    // Send an 'X' every 2 seconds
    static unsigned long lastTime = 0;
    if (millis() - lastTime > 2000) {
        lastTime = millis();
        Serial.println("ESP32: Sending 'X' to ATmega...");
        ATmegaSerial.print('X'); 
    }

    // Read information sent back from ATmega
    while (ATmegaSerial.available()) {
        Serial.write(ATmegaSerial.read());
    }
}
