upenn-embedded/final-project-s26-t16-1/code/4-10/touch_sensor.c

#define F_CPU 16000000UL

#include <avr/io.h>
#include <util/delay.h>
#include <stdlib.h>
#include <stdio.h>
#include "uart.h"

// Initialize the ADC to read from pin PC0
void initialize() {
   PRR0 &= ~(1 << PRADC);
   ADMUX = (1 << REFS0);
   DIDR0 |= (1 << ADC0D);
   ADCSRA |= (1 << ADEN) | (1 << ADPS0) | (1 << ADPS1) | (1 << ADPS2);   
}

// Read a value from the ADC
uint16_t adc_read(uint8_t ch) {
   ADMUX = (ADMUX & 0xF8) | (ch & 0x07);
   ADCSRA |= (1 << ADSC);
   while (ADCSRA & (1 << ADSC));
   return (ADC);
}

int main() {
   initialize();   
   uart_init(); 
   
   uint16_t adc_result;

   while (1) {
       // Read from ADC channel 0 (PC0)
       adc_result = adc_read(0);
       
       // Print the decimal value 
       printf("ADC Value on PC0: %u\n", adc_result);
       
       _delay_ms(250); 
   }
   return 0;
}
