upenn-embedded/final-project-s26-t16-1/(commit log)

2026-04-03 Touch sensor code
2026-04-17 Revert "debugging attempt 1"
    This reverts commit ef33023dab00a9f186a0e5503c1c9ae4ce93ad36.
    [peripheral_controller.c, uart.c]
2026-04-17 Integrate ESP-NOW for ADC data communication
    Added ESP-NOW functionality for ADC value transmission.
2026-04-17 Refactor central_controller.c for ESP32 and ATmega integration
2026-04-17 Refactor central_controller for AVR with UART and PWM
    Refactored code to implement UART and PWM functionalities, removing ESP32 specific code.
2026-04-20 hall effect
2026-04-20 hall effect thread predict logic
2026-04-22 hall effect callibrate
2026-04-24 Updated timer to use Timer 2
