upenn-embedded/final-project-s26-t16-1/sprint2-1.jpeg

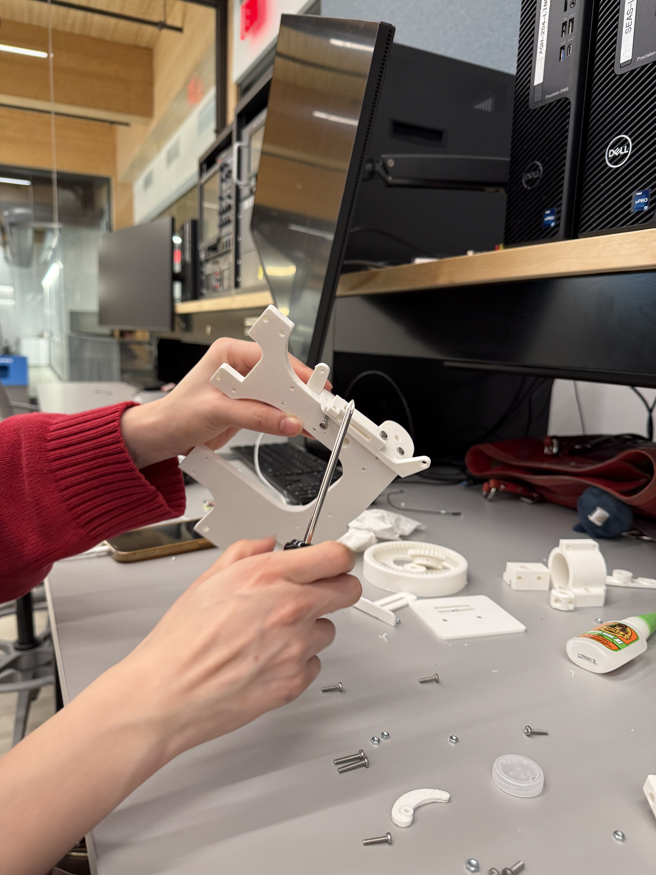
[picture p7: sprint2-1.jpeg]
sprint2-1.jpeg
