upenn-embedded/final-project-s26-t16-1/machine_assembly.JPG

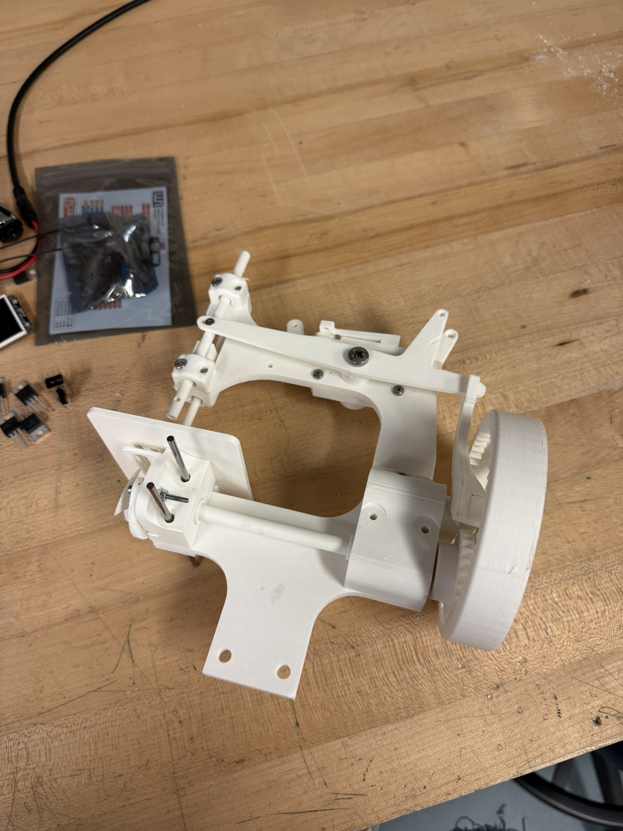
[picture p9: machine_assembly.JPG]
machine_assembly.JPG
