upenn-embedded/final-project-s26-t16-1/mvpelectronics.JPG

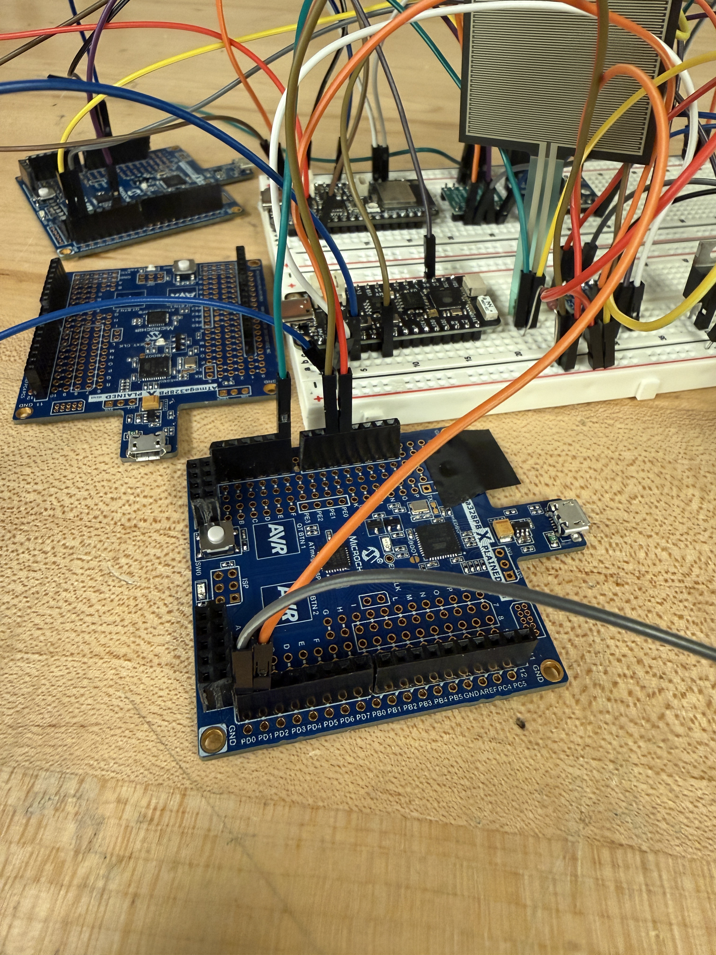
[picture p10: mvpelectronics.JPG]
mvpelectronics.JPG
